rburt16/tt08-analog-bias-generator/README.md

 

# a simple CMOS beta multiplier 1uA current source

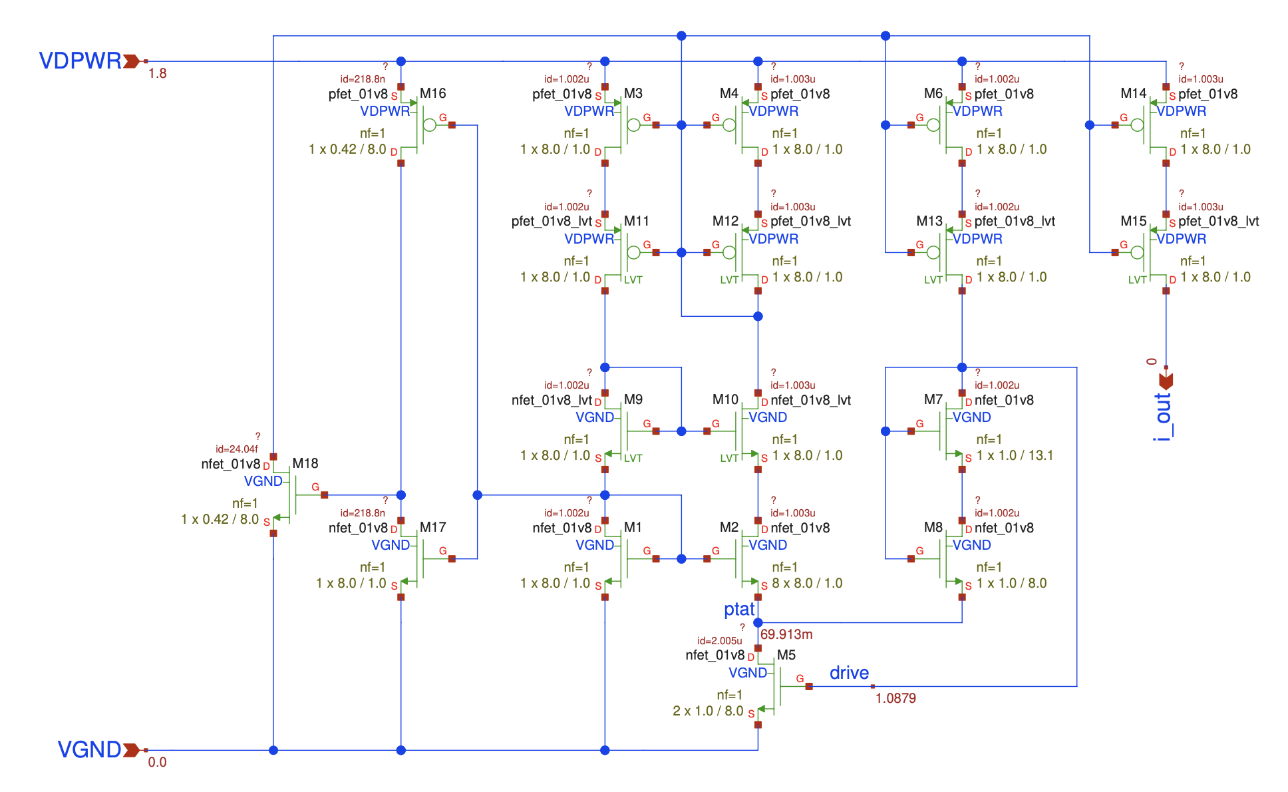
[picture p1: docs/bias_generator_circuit.png]
circuit


- [Read the documentation for project](docs/info.md)
- [Design Review](docs/bias_generator_design_review.pdf)
