rburt16/tt08-analog-bias-generator/docs/bias_generator_design_review_update_MonteCarlo.pdf

Rod Burt, Jan 30, 2025

## a simple CMOS beta multiplier 1uA current source

## - monte carlo simulation results -

## monte carlo simulation

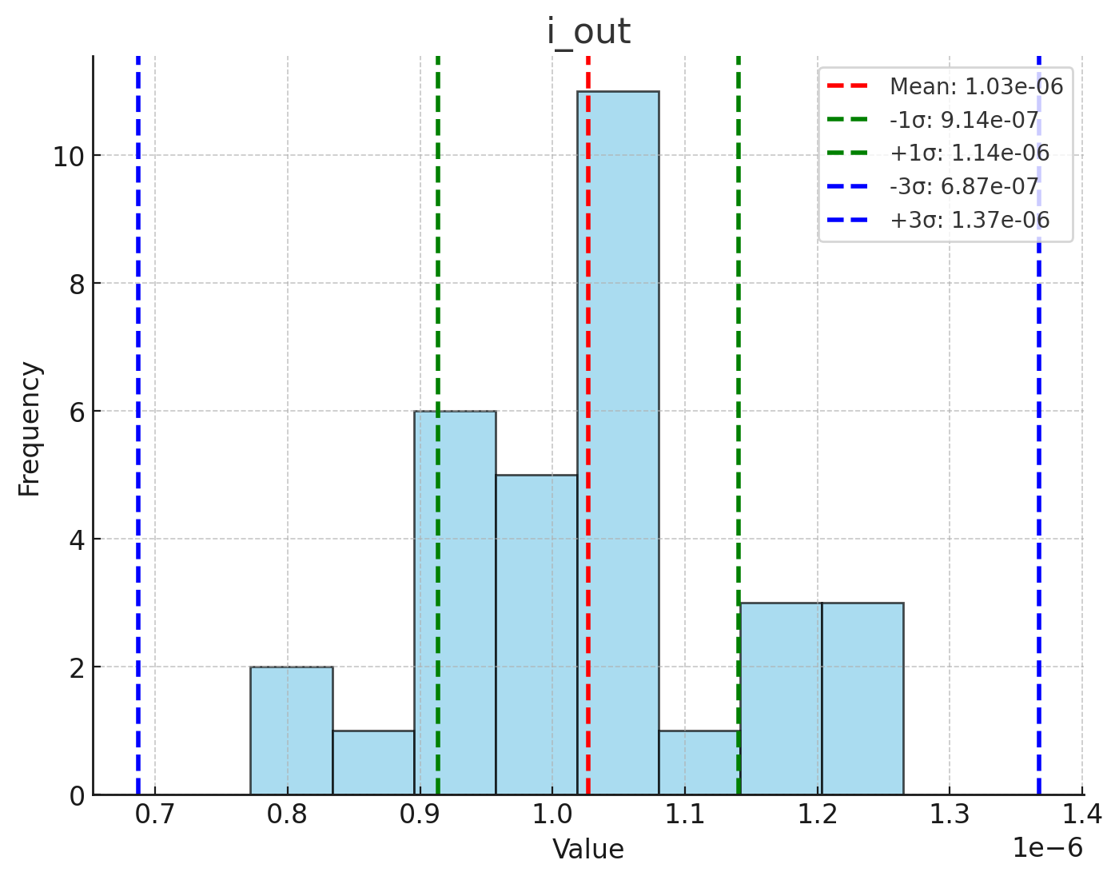
[picture p2: figure]

+/- 3 sigma ≈ +/- 34%
Unacceptable !

## monte carlo simulation of modified circuit

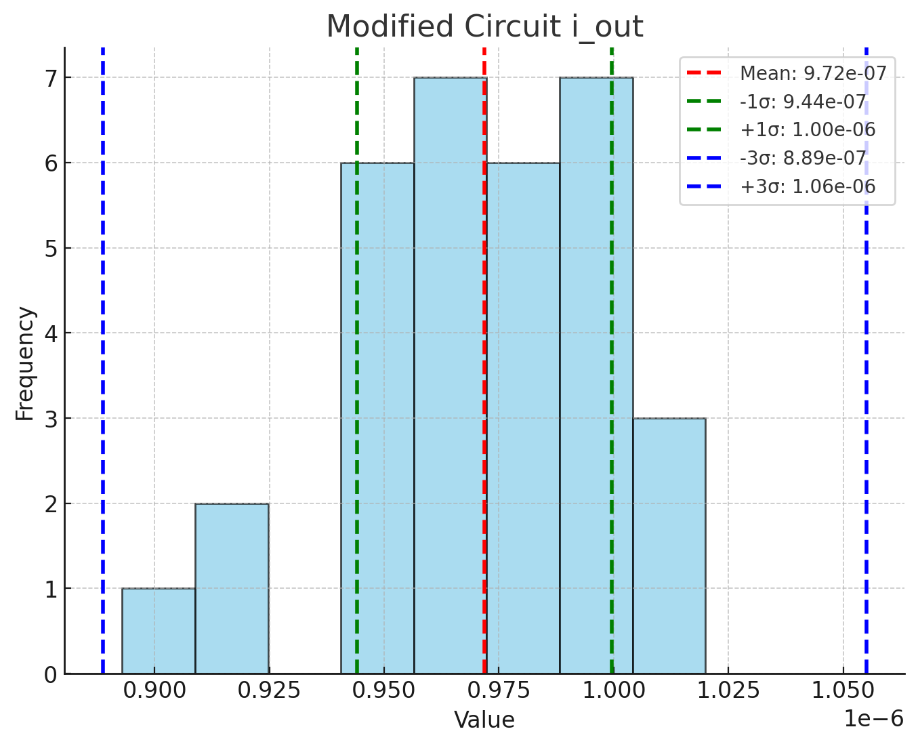
[picture p3: figure]

modified W \ L of M3, M4, M6, M14, M1, and M2 from 8 / 1 to 32 / 4

+/- 3 sigma ≈ +/- 9%
