rburt16/tt08-analog-bias-generator/docs/bias_generator_design_review.pdf

Rod Burt, Aug 8, 2024

## a simple CMOS beta multiplier 1uA current source

## - design review -

### - i_out = 1uA

### - minimize i_out variations

### - PVT variations

- Process corners ss, sf, ff, and fs
- supply Voltage from 1.7V to 1.9V
- Temperature from -40°C to 125°C

### - device mismatch

### - minimize layout area

## design goals

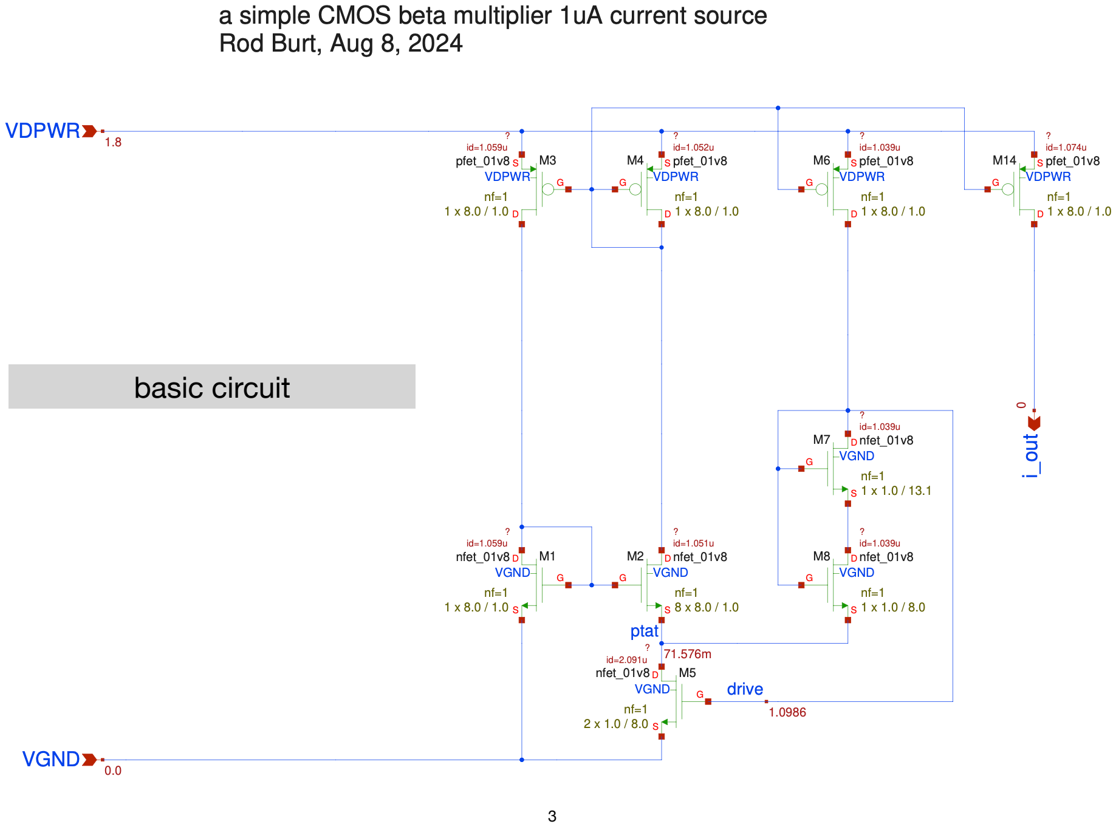
[picture p4: page 3]

basic circuit

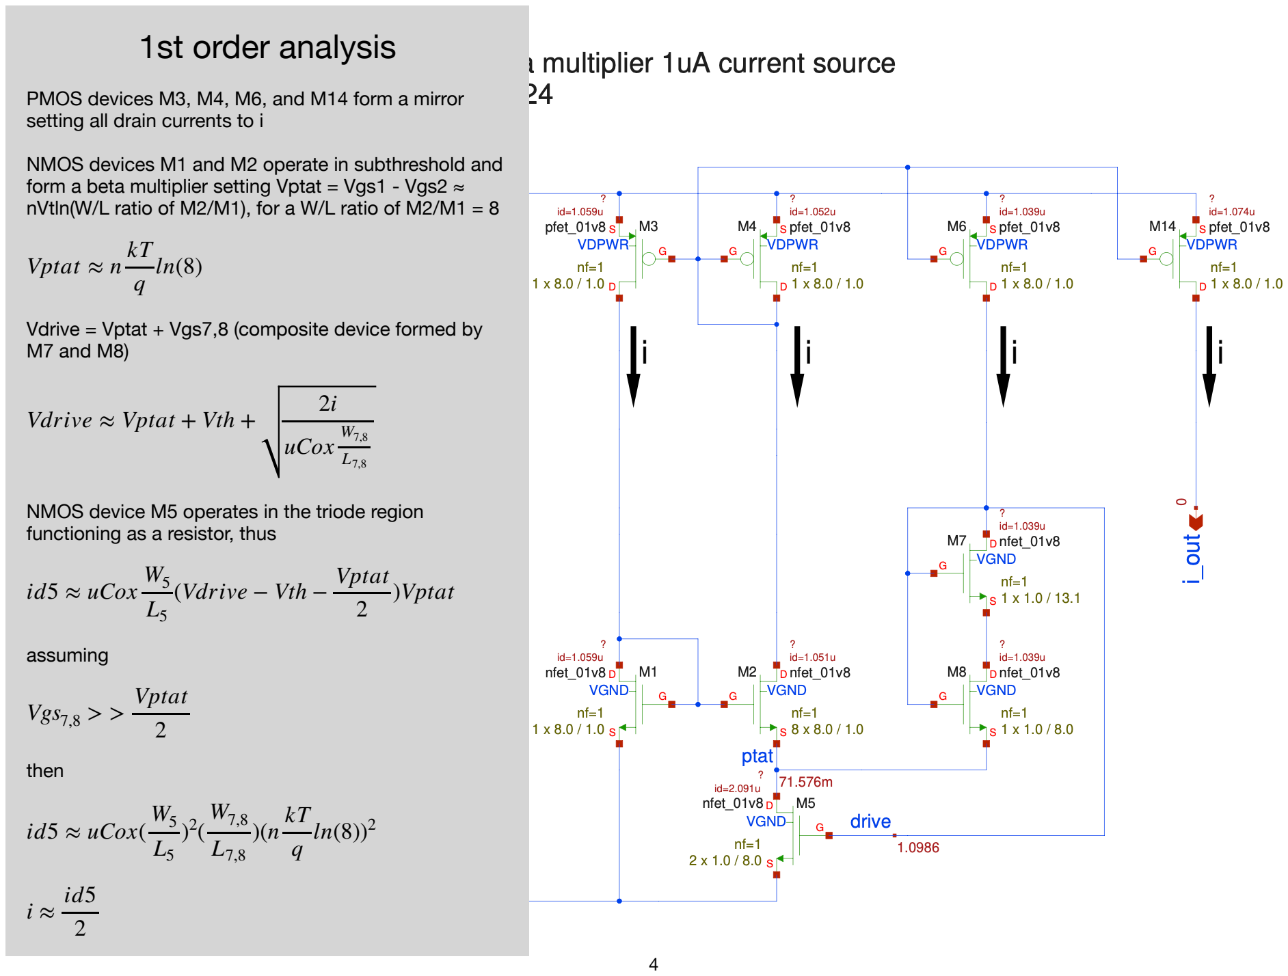
[picture p5: page 4]

1st order analysis

PMOS devices M3, M4, M6, and M14 form a mirror setting all drain currents to i

NMOS devices M1 and M2 operate in subthreshold and form a beta multiplier setting Vptat = Vgs1 - Vgs2

≈
nVtln(W/L ratio of M2/M1), for a W/L ratio of M2/M1 = 8

Vdrive = Vptat + Vgs7,8 (composite device formed by M7 and M8)

NMOS device M5 operates in the triode region functioning as a resistor, thus

assuming

### then Vpta

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
W7,8 L7,8

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
W5 L5
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
s7,8

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
W5 L5
)

2
(

W7,8 L7,8
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
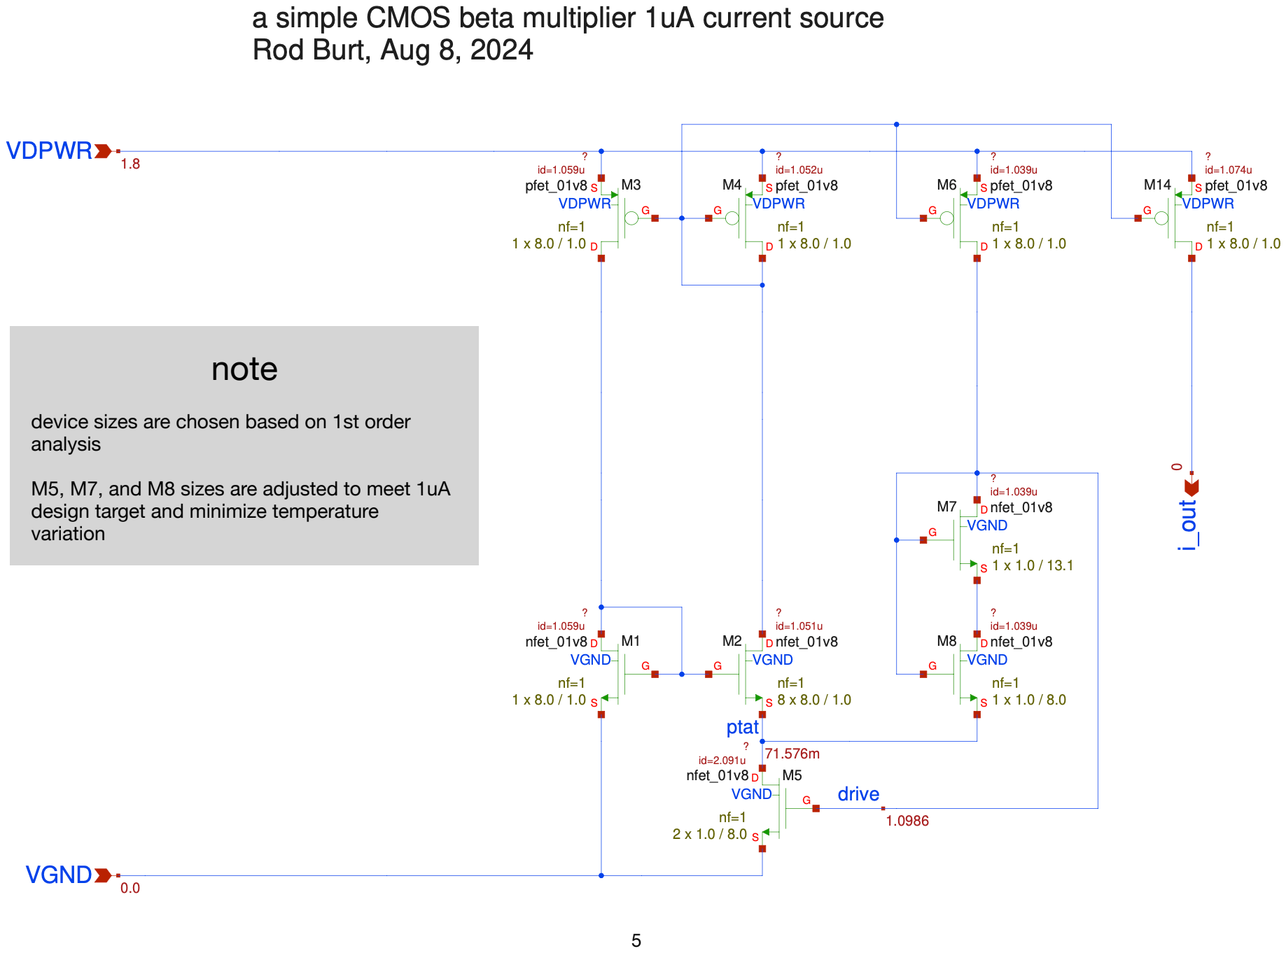
[picture p6: page 5]

note

device sizes are chosen based on 1st order analysis

M5, M7, and M8 sizes are adjusted to meet 1uA design target and minimize temperature variation

## simulation of basic circuit

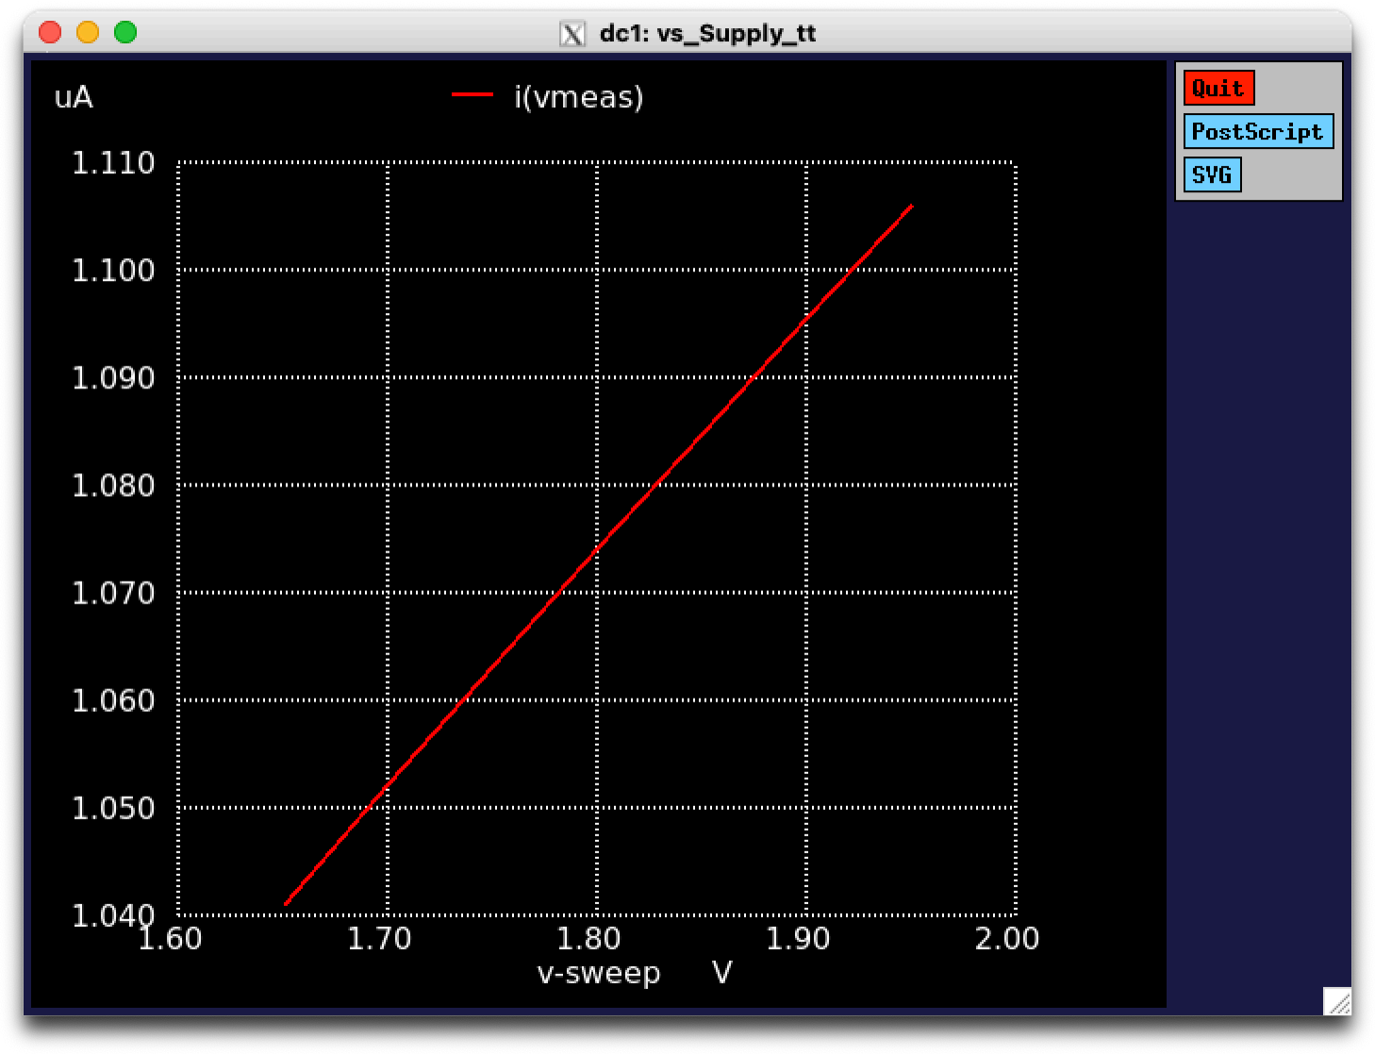
[picture p7: figure]

supply Voltage from 1.7V to 1.9V i_out variation ≈ +/- 2%

let’s minimize this before we move on to other sims!

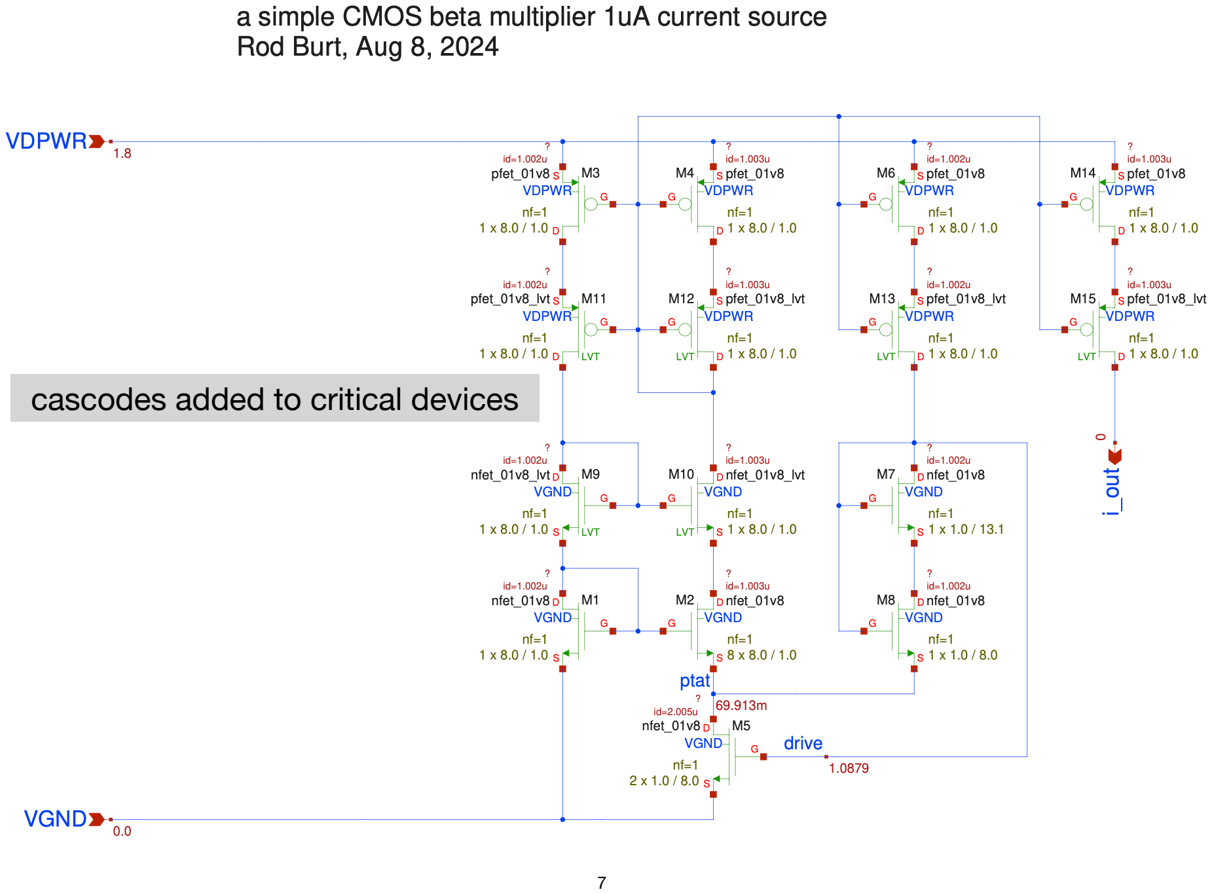
[picture p8: page 7]

cascodes added to critical devices

## simulation of circuit with cascodes

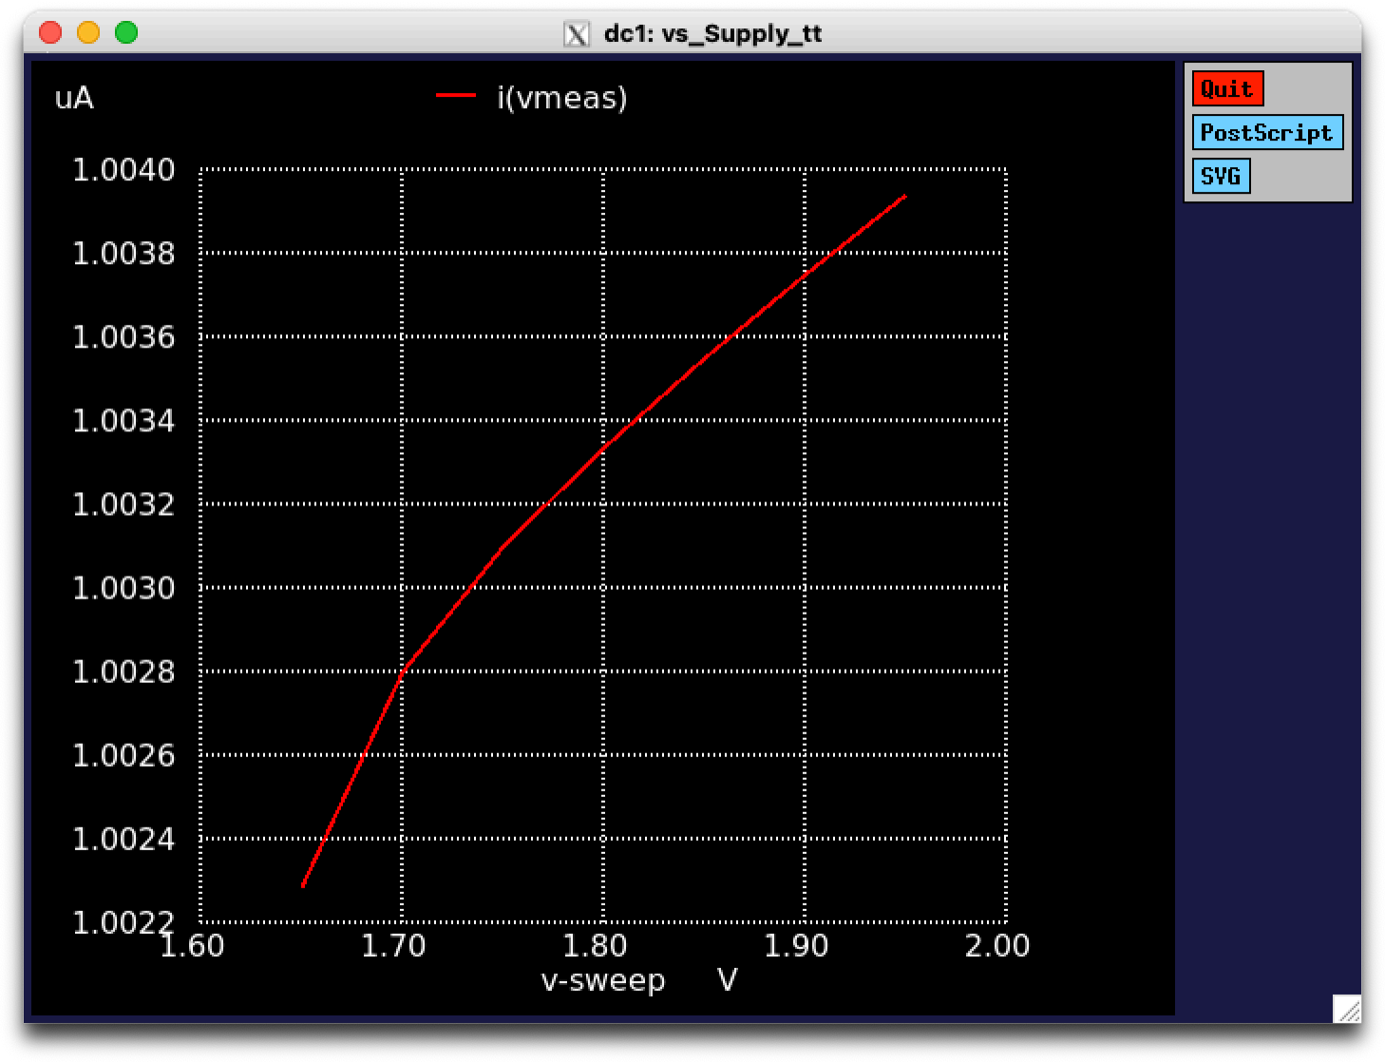
[picture p9: figure]

supply Voltage from 1.7V to 1.9V i_out variation ≈ +/- 0.5%

## simulation of circuit with cascodes

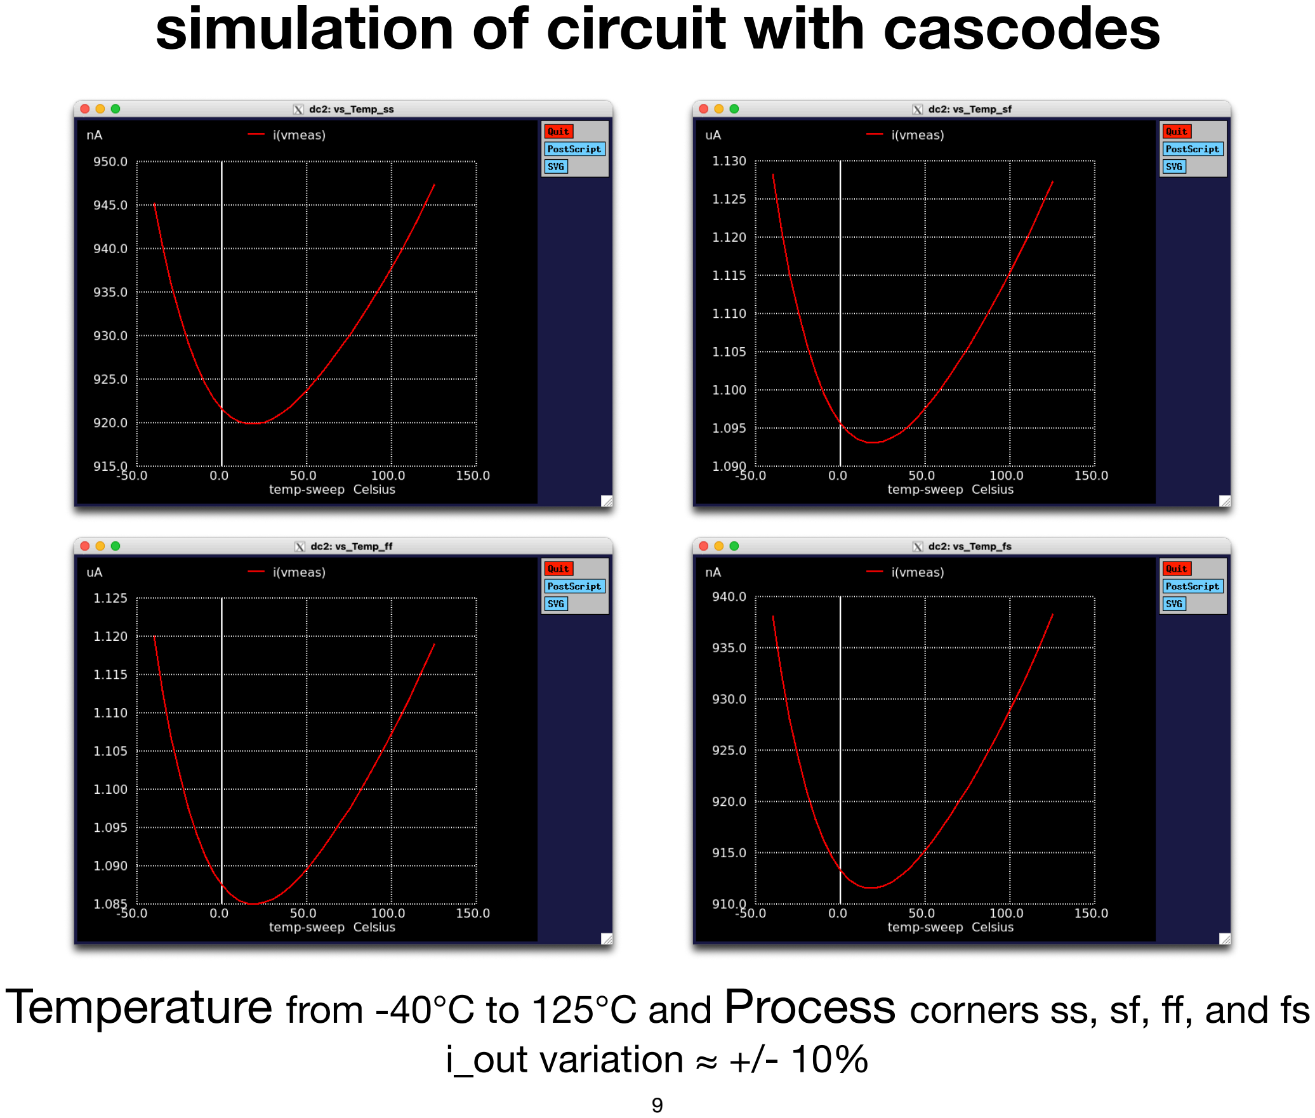
[picture p10: page 9]

Temperature from -40°C to 125°C and Process corners ss, sf, ff, and fs i_out variation ≈ +/- 10%

### - Start up

This circuit may have another valid operating point with all currents = 0. A start up circuit needs to be added to inject a small current to move the circuit into the desired state and then shut off the injected current so as not to add errors in normal operation.

### - Stability

Any feedback loop has the potential to oscillate. This circuit has 2 loops involving the ptat and drive generation. To check for the potential of instability inject a small current pulse into the loops (the ptat node is ideal since it is part of both loops) and look for the level of ringing in the response.

## final considerations

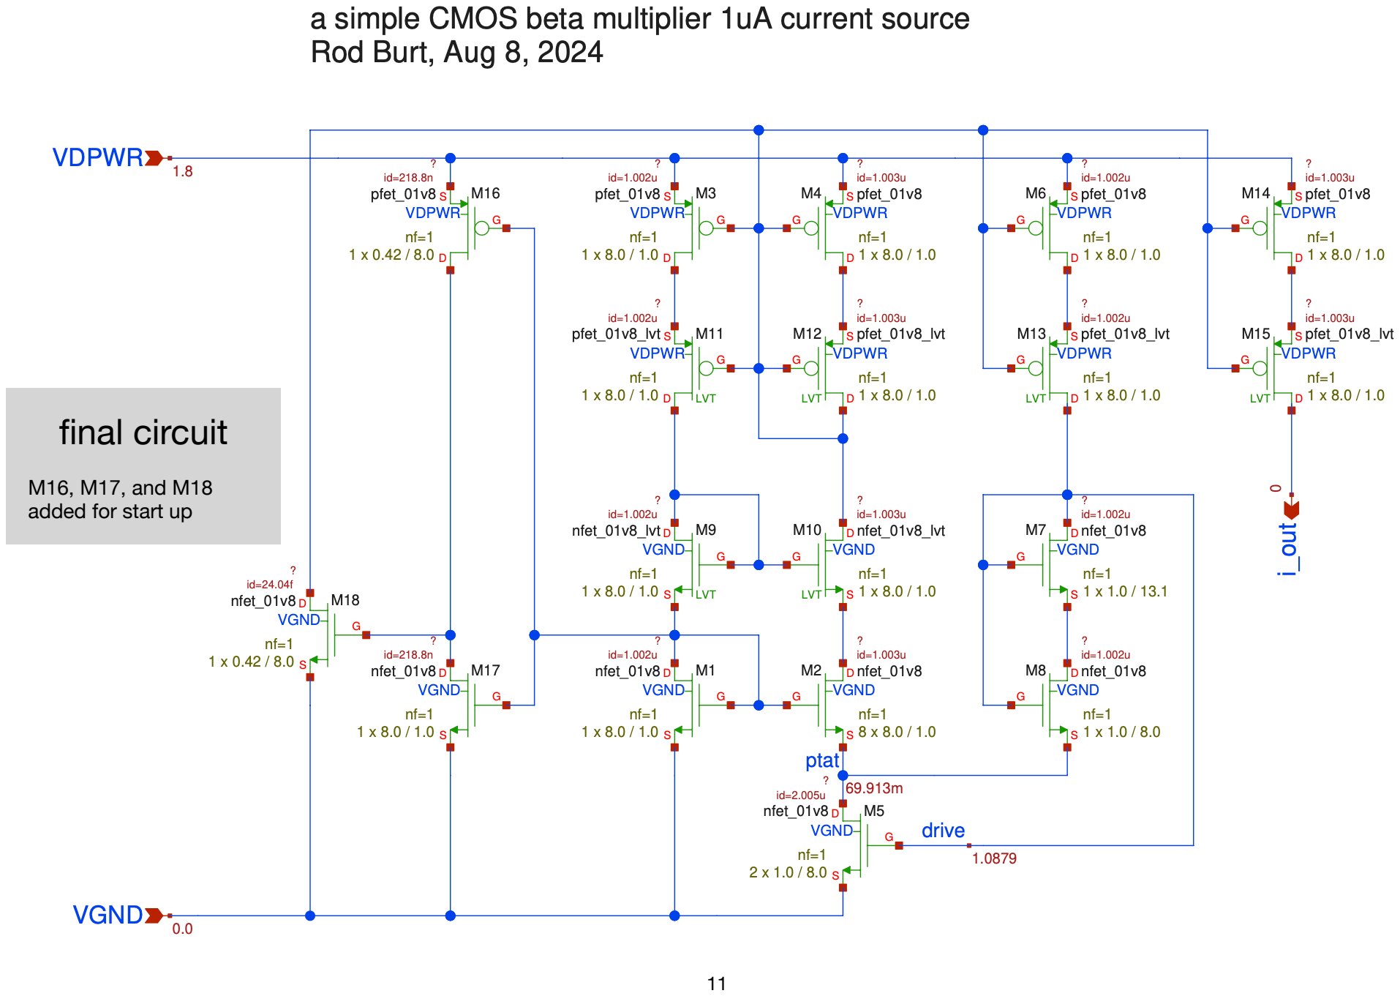
[picture p11: page 11]

final circuit

M16, M17, and M18
added for start up

## simulation of circuit with start up

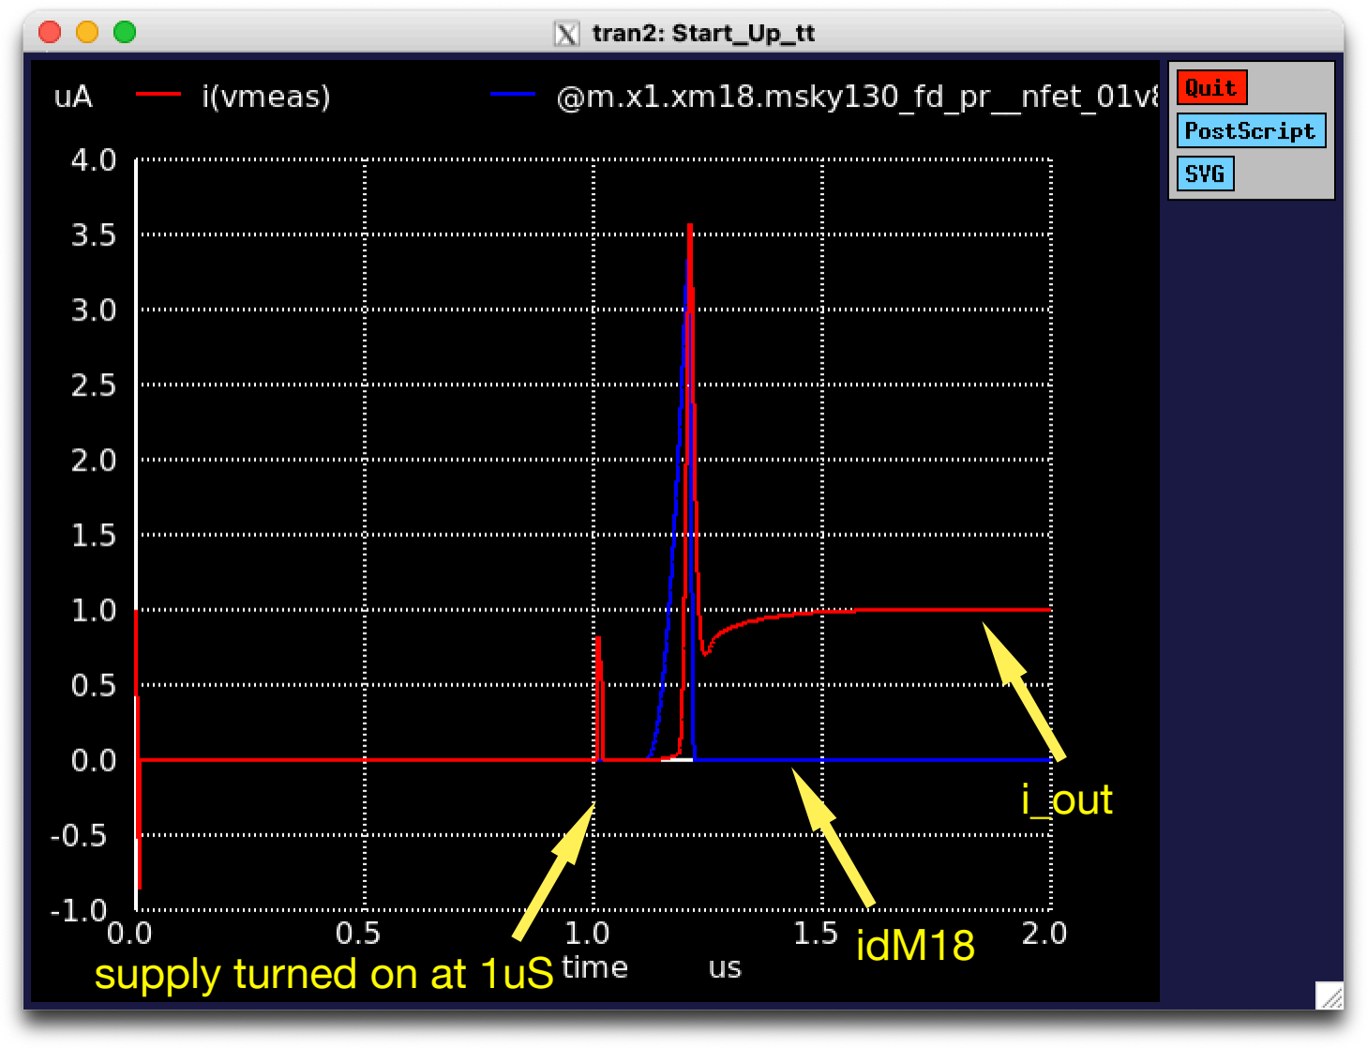
[picture p12: figure]
supply turned on at 1uS; idM18; i_out

circuit starts up and M18 turns off

## simulation to check stability

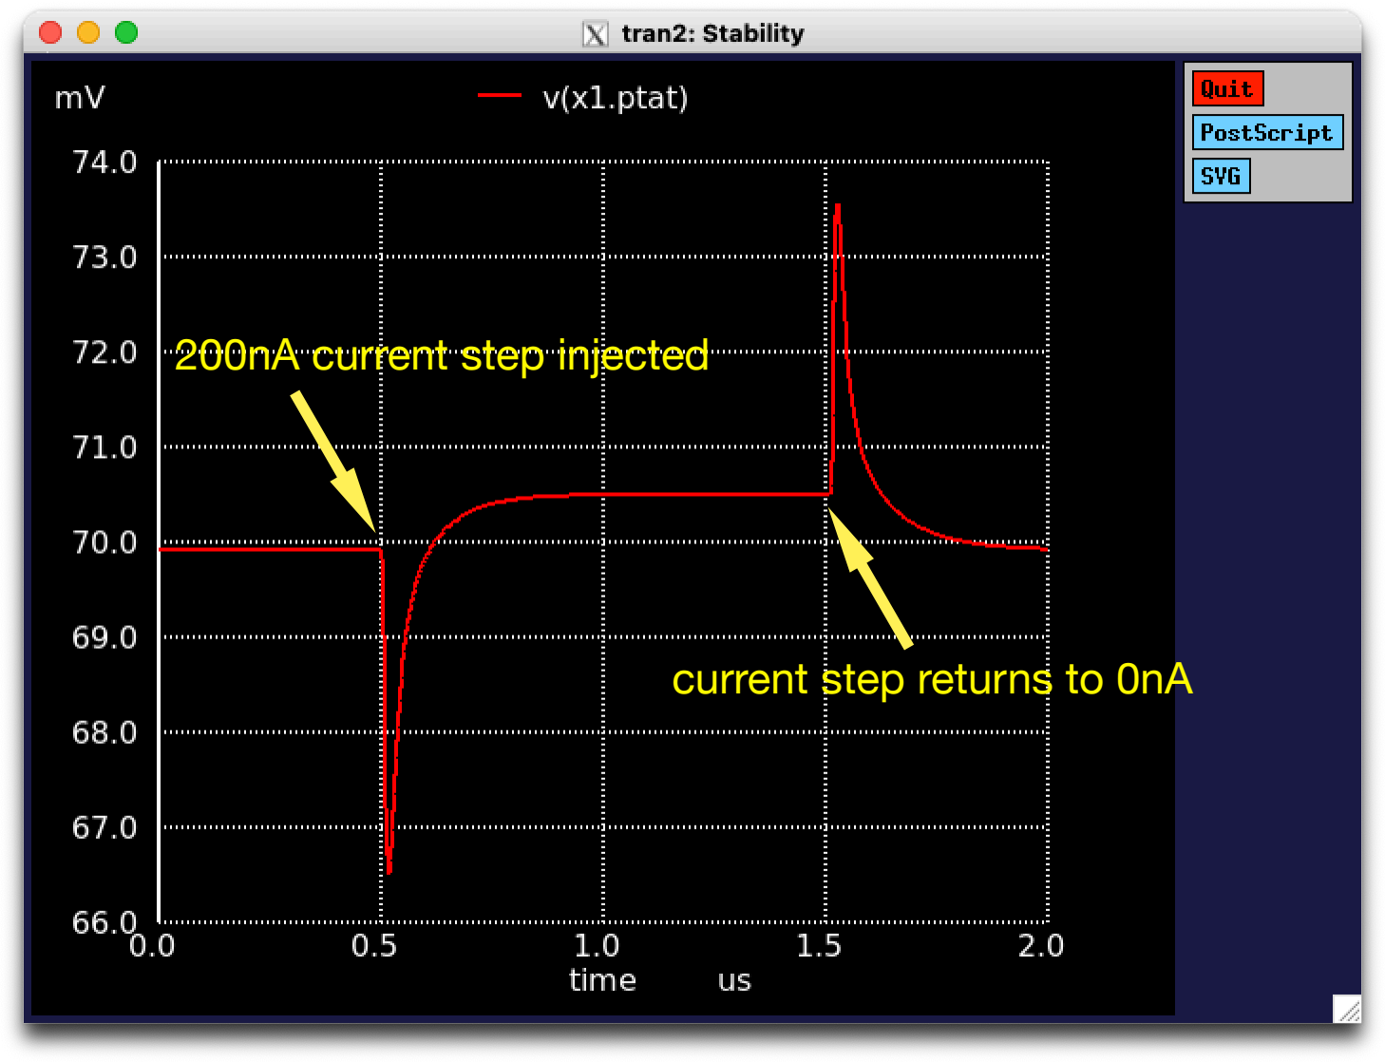
[picture p13: figure]
200nA current step injected; current step returns to 0nA

no overshoot in response indicates very good stability

### - device matching

Match both W’s and L’s and create critical ratios with device multipliers.
Insure that everything the gate sees to the edge of it’s well is the same.
Current flow from the source to the drain should be in the same direction.
For large ratios use some form of interdigitation. M1:M2's 1:8 ratio are laid out in a pattern of 4:1:4, 4 cells of M2:1 cell of M1:4 cells of M2.

### - merging devices

Parametrized layout cells on the sky130A PDK allows merging of wells.

## layout considerations

## layout

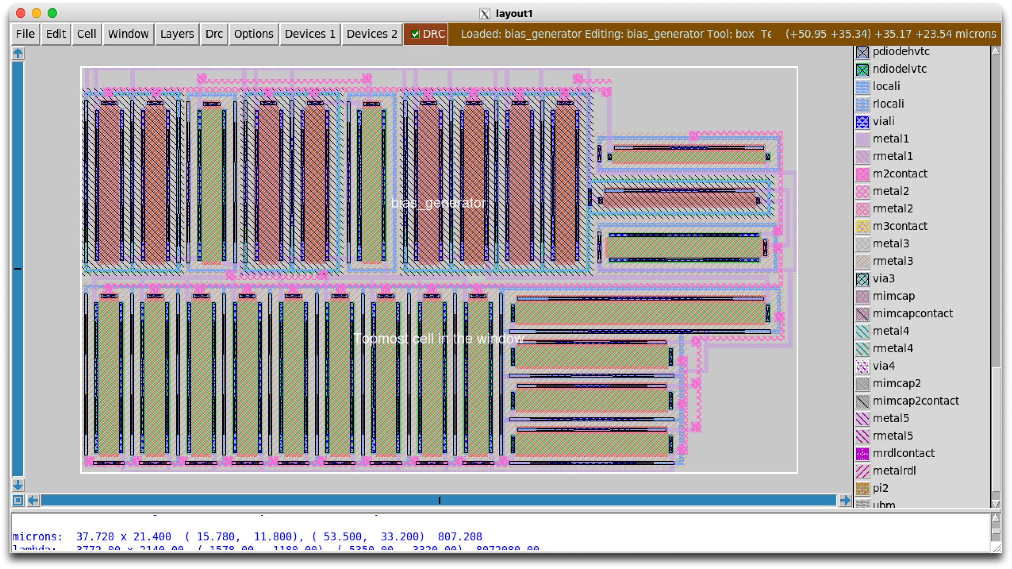
[picture p14: figure]

layout area ≈ 38um x 22 um

### - i_out = 1uA ✔

### - minimize i_out variations ✔

### - PVT variations ≈ +/- 10%

- Process corners ss, sf, ff, and fs
- supply Voltage from 1.7V to 1.9V
- Temperature from -40°C to 125°C

### - device mismatch still needs to be simulated with monti-carlo

### - minimize layout area ✔

## design goal results
