rburt16/tt08-analog-bias-generator/mag/tt08_analog_bias_generator_xschem.spice

** sch_path: /foss/designs/tt08-analog-bias-generator/xschem/tt08_analog_bias_generator.sch
**.subckt tt08_analog_bias_generator VDPWR ua[0] uio_in[7] ui_in[7] uio_in[6] ui_in[6] uio_in[5] ui_in[5] uio_in[4] ui_in[4]
*+ uio_in[3] ui_in[3] uio_in[2] ui_in[2] ui_in[1] uio_in[1] uio_in[0] ui_in[0] VGND
*.ipin ui_in[0]
*.ipin ui_in[2]
*.ipin ui_in[1]
*.ipin ui_in[3]
*.ipin ui_in[4]
*.ipin ui_in[5]
*.ipin ui_in[6]
*.ipin ui_in[7]
*.ipin uio_in[0]
*.ipin uio_in[1]
*.ipin uio_in[2]
*.ipin uio_in[3]
*.ipin uio_in[4]
*.ipin uio_in[5]
*.ipin uio_in[6]
*.ipin uio_in[7]
*.ipin VDPWR
*.ipin VGND
*.opin ua[0]
x0 VDPWR net1 VGND bias_generator
x1 VDPWR net3 VGND bias_generator
x2 VDPWR net2 VGND bias_generator
x3 VDPWR net4 VGND bias_generator
x4 VDPWR net5 VGND bias_generator
x5 VDPWR net6 VGND bias_generator
x6 VDPWR net7 VGND bias_generator
x7 VDPWR net8 VGND bias_generator
x8 VDPWR net9 VGND bias_generator
x9 VDPWR net10 VGND bias_generator
x10 VDPWR net11 VGND bias_generator
x11 VDPWR net12 VGND bias_generator
x12 VDPWR net13 VGND bias_generator
x13 VDPWR net14 VGND bias_generator
x14 VDPWR net15 VGND bias_generator
x15 VDPWR net16 VGND bias_generator
XM0 ua[0] ui_in[0] net1 VDPWR sky130_fd_pr__pfet_01v8 L=0.5 W=4 nf=1 ad='int((nf+1)/2) * W/nf * 0.29' as='int((nf+2)/2) * W/nf * 0.29'
+ pd='2*int((nf+1)/2) * (W/nf + 0.29)' ps='2*int((nf+2)/2) * (W/nf + 0.29)' nrd='0.29 / W' nrs='0.29 / W' sa=0 sb=0 sd=0 mult=1 m=1
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
XM15 ua[0] uio_in[7] net16 VDPWR sky130_fd_pr__pfet_01v8 L=0.5 W=4 nf=1 ad='int((nf+1)/2) * W/nf * 0.29' as='int((nf+2)/2) * W/nf * 0.29'
+ pd='2*int((nf+1)/2) * (W/nf + 0.29)' ps='2*int((nf+2)/2) * (W/nf + 0.29)' nrd='0.29 / W' nrs='0.29 / W' sa=0 sb=0 sd=0 mult=1 m=1
**.ends

* expanding   symbol:  /foss/designs/tt08-analog-bias-generator/xschem/bias_generator.sym # of pins=3
** sym_path: /foss/designs/tt08-analog-bias-generator/xschem/bias_generator.sym
** sch_path: /foss/designs/tt08-analog-bias-generator/xschem/bias_generator.sch
.subckt bias_generator VDPWR i_out VGND
*.ipin VGND
*.ipin VDPWR
*.opin i_out
XM9 ncascode ncascode net1 VGND sky130_fd_pr__nfet_01v8_lvt L=1.0 W=8.0 nf=1 ad='int((nf+1)/2) * W/nf * 0.29' as='int((nf+2)/2) * W/nf * 0.29'
+ pd='2*int((nf+1)/2) * (W/nf + 0.29)' ps='2*int((nf+2)/2) * (W/nf + 0.29)' nrd='0.29 / W' nrs='0.29 / W' sa=0 sb=0 sd=0 mult=1 m=1
XM10 pgate ncascode net4 VGND sky130_fd_pr__nfet_01v8_lvt L=1.0 W=8.0 nf=1 ad='int((nf+1)/2) * W/nf * 0.29' as='int((nf+2)/2) * W/nf * 0.29'
+ pd='2*int((nf+1)/2) * (W/nf + 0.29)' ps='2*int((nf+2)/2) * (W/nf + 0.29)' nrd='0.29 / W' nrs='0.29 / W' sa=0 sb=0 sd=0 mult=1 m=1
XM2 net4 net1 ptat VGND sky130_fd_pr__nfet_01v8 L=1.0 W=8.0 nf=1 ad='int((nf+1)/2) * W/nf * 0.29' as='int((nf+2)/2) * W/nf * 0.29'
+ pd='2*int((nf+1)/2) * (W/nf + 0.29)' ps='2*int((nf+2)/2) * (W/nf + 0.29)' nrd='0.29 / W' nrs='0.29 / W' sa=0 sb=0 sd=0 mult=8 m=8
XM18 pgate startup VGND VGND sky130_fd_pr__nfet_01v8 L=8.0 W=0.42 nf=1 ad='int((nf+1)/2) * W/nf * 0.29' as='int((nf+2)/2) * W/nf * 0.29'
+ pd='2*int((nf+1)/2) * (W/nf + 0.29)' ps='2*int((nf+2)/2) * (W/nf + 0.29)' nrd='0.29 / W' nrs='0.29 / W' sa=0 sb=0 sd=0 mult=1 m=1
XM17 startup net1 VGND VGND sky130_fd_pr__nfet_01v8 L=1.0 W=8.0 nf=1 ad='int((nf+1)/2) * W/nf * 0.29' as='int((nf+2)/2) * W/nf * 0.29'
+ pd='2*int((nf+1)/2) * (W/nf + 0.29)' ps='2*int((nf+2)/2) * (W/nf + 0.29)' nrd='0.29 / W' nrs='0.29 / W' sa=0 sb=0 sd=0 mult=1 m=1
XM1 net1 net1 VGND VGND sky130_fd_pr__nfet_01v8 L=1.0 W=8.0 nf=1 ad='int((nf+1)/2) * W/nf * 0.29' as='int((nf+2)/2) * W/nf * 0.29'
+ pd='2*int((nf+1)/2) * (W/nf + 0.29)' ps='2*int((nf+2)/2) * (W/nf + 0.29)' nrd='0.29 / W' nrs='0.29 / W' sa=0 sb=0 sd=0 mult=1 m=1
XM5 ptat drive VGND VGND sky130_fd_pr__nfet_01v8 L=8.0 W=1.0 nf=1 ad='int((nf+1)/2) * W/nf * 0.29' as='int((nf+2)/2) * W/nf * 0.29'
+ pd='2*int((nf+1)/2) * (W/nf + 0.29)' ps='2*int((nf+2)/2) * (W/nf + 0.29)' nrd='0.29 / W' nrs='0.29 / W' sa=0 sb=0 sd=0 mult=2 m=2
XM7 drive drive net3 VGND sky130_fd_pr__nfet_01v8 L=13.1 W=1.0 nf=1 ad='int((nf+1)/2) * W/nf * 0.29' as='int((nf+2)/2) * W/nf * 0.29'
+ pd='2*int((nf+1)/2) * (W/nf + 0.29)' ps='2*int((nf+2)/2) * (W/nf + 0.29)' nrd='0.29 / W' nrs='0.29 / W' sa=0 sb=0 sd=0 mult=1 m=1
XM8 net3 drive ptat VGND sky130_fd_pr__nfet_01v8 L=8.0 W=1.0 nf=1 ad='int((nf+1)/2) * W/nf * 0.29' as='int((nf+2)/2) * W/nf * 0.29'
+ pd='2*int((nf+1)/2) * (W/nf + 0.29)' ps='2*int((nf+2)/2) * (W/nf + 0.29)' nrd='0.29 / W' nrs='0.29 / W' sa=0 sb=0 sd=0 mult=1 m=1
XM4 net2 pgate VDPWR VDPWR sky130_fd_pr__pfet_01v8 L=1.0 W=8.0 nf=1 ad='int((nf+1)/2) * W/nf * 0.29' as='int((nf+2)/2) * W/nf * 0.29'
+ pd='2*int((nf+1)/2) * (W/nf + 0.29)' ps='2*int((nf+2)/2) * (W/nf + 0.29)' nrd='0.29 / W' nrs='0.29 / W' sa=0 sb=0 sd=0 mult=1 m=1
XM6 net6 pgate VDPWR VDPWR sky130_fd_pr__pfet_01v8 L=1.0 W=8.0 nf=1 ad='int((nf+1)/2) * W/nf * 0.29' as='int((nf+2)/2) * W/nf * 0.29'
+ pd='2*int((nf+1)/2) * (W/nf + 0.29)' ps='2*int((nf+2)/2) * (W/nf + 0.29)' nrd='0.29 / W' nrs='0.29 / W' sa=0 sb=0 sd=0 mult=1 m=1
XM14 net7 pgate VDPWR VDPWR sky130_fd_pr__pfet_01v8 L=1.0 W=8.0 nf=1 ad='int((nf+1)/2) * W/nf * 0.29' as='int((nf+2)/2) * W/nf * 0.29'
+ pd='2*int((nf+1)/2) * (W/nf + 0.29)' ps='2*int((nf+2)/2) * (W/nf + 0.29)' nrd='0.29 / W' nrs='0.29 / W' sa=0 sb=0 sd=0 mult=1 m=1
XM3 net5 pgate VDPWR VDPWR sky130_fd_pr__pfet_01v8 L=1.0 W=8.0 nf=1 ad='int((nf+1)/2) * W/nf * 0.29' as='int((nf+2)/2) * W/nf * 0.29'
+ pd='2*int((nf+1)/2) * (W/nf + 0.29)' ps='2*int((nf+2)/2) * (W/nf + 0.29)' nrd='0.29 / W' nrs='0.29 / W' sa=0 sb=0 sd=0 mult=1 m=1
XM16 startup net1 VDPWR VDPWR sky130_fd_pr__pfet_01v8 L=8.0 W=0.42 nf=1 ad='int((nf+1)/2) * W/nf * 0.29' as='int((nf+2)/2) * W/nf * 0.29'
+ pd='2*int((nf+1)/2) * (W/nf + 0.29)' ps='2*int((nf+2)/2) * (W/nf + 0.29)' nrd='0.29 / W' nrs='0.29 / W' sa=0 sb=0 sd=0 mult=1 m=1
XM12 pgate pgate net2 VDPWR sky130_fd_pr__pfet_01v8_lvt L=1.0 W=8.0 nf=1 ad='int((nf+1)/2) * W/nf * 0.29' as='int((nf+2)/2) * W/nf * 0.29'
+ pd='2*int((nf+1)/2) * (W/nf + 0.29)' ps='2*int((nf+2)/2) * (W/nf + 0.29)' nrd='0.29 / W' nrs='0.29 / W' sa=0 sb=0 sd=0 mult=1 m=1
XM13 drive pgate net6 VDPWR sky130_fd_pr__pfet_01v8_lvt L=1.0 W=8.0 nf=1 ad='int((nf+1)/2) * W/nf * 0.29' as='int((nf+2)/2) * W/nf * 0.29'
+ pd='2*int((nf+1)/2) * (W/nf + 0.29)' ps='2*int((nf+2)/2) * (W/nf + 0.29)' nrd='0.29 / W' nrs='0.29 / W' sa=0 sb=0 sd=0 mult=1 m=1
XM15 i_out pgate net7 VDPWR sky130_fd_pr__pfet_01v8_lvt L=1.0 W=8.0 nf=1 ad='int((nf+1)/2) * W/nf * 0.29' as='int((nf+2)/2) * W/nf * 0.29'
+ pd='2*int((nf+1)/2) * (W/nf + 0.29)' ps='2*int((nf+2)/2) * (W/nf + 0.29)' nrd='0.29 / W' nrs='0.29 / W' sa=0 sb=0 sd=0 mult=1 m=1
XM11 ncascode pgate net5 VDPWR sky130_fd_pr__pfet_01v8_lvt L=1.0 W=8.0 nf=1 ad='int((nf+1)/2) * W/nf * 0.29' as='int((nf+2)/2) * W/nf * 0.29'
+ pd='2*int((nf+1)/2) * (W/nf + 0.29)' ps='2*int((nf+2)/2) * (W/nf + 0.29)' nrd='0.29 / W' nrs='0.29 / W' sa=0 sb=0 sd=0 mult=1 m=1
.ends

.end
